0wn3r/stmbl/conf/fanuc_a05_spindle_foc_sl.txt

# Fanuc alpha 0.5 induction spindle motor, TENV
# [plate] A06B-0866-B380, delta, 4 poles, PF 0.65,
#   85-200 V (85 V at 3000 rpm, 100 Hz), S1 0.55 kW
#   3000-8000 rpm 7.0 A, S2 15 min 1.1 kW 11 A
# [plate] B-65152E: S1 0.55 kW 7 A rms (9.9 pk),
#   15 min / S3 40 % 1.1 kW 11 A rms (15.6 pk),
#   1.75 Nm S1 / 3.5 Nm S3 to base 3000 rpm,
#   max 8000 rpm, J 0.00048 kgm2, 1.32 kW max
#   during acceleration, MZ sensor 64 teeth
# Fanuc amp SPM-2.2 (200 V), model code 100;
#   B-65160E/02 app. C (conventional / HRV):
#   4100 3000/3200, 4102 5500/6524, 4103 5500/0,
#   4110 2155/1886, 4111 26/361, 4112 652/200,
#   4113 1000/1900, 4114 10/0, 4115 5/100
# [est] the manuals give no R, L, Tr or Im: the
#   electrical values below are estimates (flux
#   0.11 Vs from 85 V at 100 Hz; magnetizing
#   5.1 A pk from the SPM 9D20 firmware's 4110
#   ratio to the alpha 2; tr 40 ms from 4113
#   1000 vs 450, scaled by our measured alpha 2;
#   S1 torque then needs 5.3 A pk q current,
#   7.4 A pk in all). Run idacim on the motor
#   and replace every [est].
# sized for the v4.0 board: 5.1 A DC at rest
#   keeps the IRAM256-2067A under its derate
# variant: rotor flux FOC sensorless (S3): I/f
# start, observer above w_hand. No encoder.
# i_f, align, w_hand, hyst, obs0.bw derived
link pid
link acim_foc
link sl_acim
# drive: v4.0 board, IRAM256-2067A (30 A peak)
link ocdac
ocdac0.cur = 20 # 1.3 x max_ac_cur, measure the map first
conf0.max_ac_cur = 15 # [plate] S3 15.6 A pk
conf0.max_dc_cur = 8 # 1.32 kW at 300 V is 4.4 A
iit0.cur_boost = 1.515 # S1 9.9 A pk
iit0.max_time = 900 # S3 for 15 min
hv0.drop_k = 0.885 # dead time comp, fit per board
hv0.drop_knee = 0.85
conf0.cur_ff = 1 # r feed forward (as the alpha 2, bench 2 Nov)
conf0.cur_ind = 0 # sim: 1 slows the sensorless run up near the top
conf0.polecount = 2 # [plate]
conf0.max_vel = 838 # [plate] 8000 rpm
conf0.lq = 0 # acim_foc: l is the leakage only
conf0.psi = 0 # hv0.psi comes from acim_flux0
conf0.max_acc = 100 # raise after id_pid
conf0.max_sat = 5
acim_fw0.duty = hv0.duty
acim_fw0.p_max = 1100 # [plate] S3
# speed command through a ramp:
# ramp0.vel_ext_cmd [rad/s], enable: ramp0.en
load ramp
ramp0.rt_prio = 5.1
ramp0.vel_ext_cmd = rev0.out_d
ramp0.en = 0 # set 1 to run
ramp0.max_vel = conf0.max_vel
ramp0.max_acc = conf0.max_acc
ramp0.max_dec = conf0.max_acc
ramp0.en_delay = 0.3 # flux builds before the ramp
fault0.en = ramp0.en_out
pid0.pos_en = 0
conf0.j_sys = 0 # [est]
fault0.fb_ready = 1
fault0.mot_fb_error = 0
fault0.vel_fb = obs0.vel_m
sl_seq0.vel_cmd = ramp0.vel_cmd
pid0.acc_ext_cmd = 0
# ---- motor values (replace with idacim) ----
conf0.out_rev = 1 # [est]
conf0.r = 1.0 # [est]
conf0.l = 0.0012 # [est] leakage, Fanuc 4116 scaled on the alpha 2
acim_flux0.tr = 0.04 # [est] Fanuc 4113
acim_flux0.lmr = 0.0216 # [est] psi 0.11 / 5.1 A
acim_foc0.id_n = 5.1 # [est] Fanuc 4110
acim_flux0.i_n = 5.1 # [est]
acim_foc0.max_cur_0 = 7.5 # IRAM near DC, Fig. 5 at Tc 100 C
acim_foc0.k_boost = 2 # flux boost
acim_foc0.boost_max = 0.3
acim_foc0.k_cut = 2 # flux cut
conf0.j = 0.0008 # [est] rotor + pulley
conf0.j_sys = 0 # [est]
conf0.f = 0.06 # [est]
conf0.d = 0.00016 # [est]
conf0.o = 0
conf0.max_force = 3.5 # [plate] S3 torque
conf0.vel_bw = 80 # [est] the alpha 2 speed mode value
