0wn3r/stmbl/conf/fanuc_a2_spindle_foc_enc.txt

# Fanuc alpha 2 induction spindle motor, fan cooled
# [plate] A06B-0852-B190#3000, delta, 4 poles
#   (2 pole pairs), S1 2.2 kW 19 A rms (26.9 pk),
#   S2 15 min / S3 60 % 3.7 kW 27 A rms, 14.0 Nm,
#   base 1500 rpm, max 8000 rpm, J 0.0078 kgm2,
#   110-216 V, overload 120 % of 30 min, 1 min
# idacim input: 155 V at 78.4 Hz (2352 rpm)
# original Fanuc amp: SPM-5.5 A06B-6078-H206#H500,
#   27 A rms, 200-230 V in; parameters (FS16i,
#   B-65160E/02 app. C, units not recorded):
#   4020 max speed 8000, 4100 power base 1750,
#   4101 100, 4102 base speed 2352, 4103 flux
#   down start 2352, 4104/4105 cur P 1300,
#   4106/4107 cur I 1500, 4108 300, 4110 585,
#   4111 22, 4112 783, 4113 slip 450, 4114 high
#   speed slip comp 10, 4115 dead time comp 2,
#   motor model code 103
# [id] 13 Oct 2026 from a clean config, no hand
#   values: idacim (standstill, rotating,
#   ramps tr) + pole/direction test, id_sys
#   on the encoder, conf0.max_force =
#   acim_foc0.t_max, id_pid speed mode
#   (idacim_rot_tr df22b814)
# checked 13 Oct: 0 to +-838 rad/s both ways,
# no fault, orientation within 0.055 rad
# variant: rotor flux FOC on the encoder (S1)
link pid
link acim_foc
# encoder: 512 line sin/cos (magnetic) on fb0;
#   iabs_pos keeps the interpolation after the index
link enc_fb0
conf0.mot_fb_res = 512
enc_fb0.ires = 32
fb_switch0.mot_pos = enc_fb0.ipos
fb_switch0.mot_abs_pos = enc_fb0.iabs_pos
enc_fb0.off_k = 0.0002 # single ended sin/cos: offsets tracked, ~1 s
adc0.sin_gain = 1.5 # magnetic encoder, low amp
adc0.cos_gain = 1.5
# drive: v4.0 board, IRAM256-2067A (30 A peak)
link ocdac
ocdac0.cur = 30 # measure the map first (ocdac)
conf0.max_ac_cur = 28 # under the module's 30 A peak
conf0.max_dc_cur = 30
iit0.cur_boost = 1.1896 # S1 26.9 A pk
iit0.max_time = 1452 # S2 32 A for 30 min
hv0.drop_k = 0.885 # dead time comp, fit per board
hv0.drop_knee = 0.85
conf0.polecount = 2 # [plate]
conf0.max_vel = 838 # [plate] 8000 rpm
conf0.lq = 0 # acim_foc: l is the leakage only
conf0.psi = 0 # hv0.psi comes from acim_flux0
conf0.max_acc = 97.5 # 65% of the belt's 150
conf0.max_sat = 5
acim_fw0.duty = hv0.duty
acim_fw0.p_max = 2200 # [plate] S1, x cur_boost
# speed command through a ramp:
# ramp0.vel_ext_cmd [rad/s], enable: ramp0.en
load ramp
ramp0.rt_prio = 5.1
ramp0.vel_ext_cmd = rev0.out_d
ramp0.en = 0 # set 1 to run
ramp0.max_vel = conf0.max_vel
ramp0.max_acc = conf0.max_acc
ramp0.max_dec = conf0.max_acc
# power limited ramp: acc <= p / (j * vel)
ramp0.j = 0.0131 # conf0.j + j_sys, with tool
ramp0.p_acc = 2700 # drive power - drag at max_vel
ramp0.p_dec = 3000 # regen power when braking
ramp0.en_delay = 0.3 # flux builds before the ramp
fault0.en = ramp0.en_out
pid0.pos_en = 0
conf0.j_sys = 0
pid0.vel_ext_cmd = ramp0.vel_cmd
pid0.acc_ext_cmd = 0
# ---- identified (appended by the ID runs) ----
# idacim 13 Oct 15:52 (157ab726), pp test 15:57
conf0.out_rev = 1 # [idacim pp]
conf0.r = 0.193065 # [idacim]
conf0.l = 0.000747 # [idacim]
acim_flux0.tr = 0.101055 # [idacim]
acim_flux0.lmr = 0.01298 # [idacim]
acim_foc0.id_n = 18.738 # [idacim]
acim_foc0.max_cur_0 = 30 # IM06B50GC1 IC 35 A DC
acim_foc0.k_boost = 2 # flux boost
acim_foc0.boost_max = 0.3
acim_foc0.k_cut = 2 # flux cut, sim 29 Oct
acim_flux0.i_n = 18.738 # [idacim]
acim_flux0.lmr_sat = 0.060129 # [idacim]
acim_flux0.i_knee = 8.81171 # [idacim]
acim_flux0.tr_sat = 0.060129 # [idacim]
acim_flux0.i_dip = 8.22607 # [idacim]
acim_flux0.lmr_dip = 0.058238 # [idacim]
acim_flux0.tr_dip = 0.058238 # [idacim]
conf0.j = 0.012124 # [idacim]
# id_sys 13 Oct 16:10, encoder, 30-300 rad/s
conf0.j_sys = 0.001023 # [id_sys]
conf0.f = 0.483618 # [id_sys]
conf0.d = 0.00107 # [id_sys]
conf0.o = 0.005652 # [id_sys]
conf0.max_force = 18.8 # acim_foc0.t_max, full flux
# id_pid speed mode 13 Oct 18:39 (256a2abf)
conf0.vel_bw = 79.66 # [id_pid speed mode]
