0wn3r/stmbl/shared/f3hw.h

#include "stm32f3xx_ll_gpio.h"

//stmbl v4.0, IRAM256-2067A
#define AREF 3.338  // analog reference voltage
//PA15 drives the IRAM's FLT/EN through R129 (1k): high runs the module, low
//turns all six switches off (FLT/EN filter about 200 ns). The IRAM pulls the
//same node low on an ITRIP fault, which PB7 reads.
#define HV_EN_PIN LL_GPIO_PIN_15
#define HV_EN_PORT GPIOA
#define HV_EN_ON() LL_GPIO_SetOutputPin(HV_EN_PORT, HV_EN_PIN)
#define HV_EN_OFF() LL_GPIO_ResetOutputPin(HV_EN_PORT, HV_EN_PIN)
//fault pin cannot be used, as it is sometimes reset by the iram due to 15v ripple
#define HV_FAULT_PIN LL_GPIO_PIN_7
#define HV_FAULT_PORT GPIOB
#define HV_FAULT_POLARITY 0
#define LED_PIN LL_GPIO_PIN_8
#define LED_PORT GPIOA
#define BRK_PIN LL_GPIO_PIN_2
#define BRK_PORT GPIOB

#define VDIVUP 249000.0 * 2.0  //HV div pullup R1,R12
#define VDIVDOWN 3900.0        //HV div pulldown R2,R9
#define SHUNT 0.003            //shunt
#define SHUNT_PULLUP 15000.0
#define SHUNT_SERIE 470.0

#define PWM_U TIM8->CCR3
#define PWM_V TIM8->CCR2
#define PWM_W TIM8->CCR1

#define PWM_TIM_CLK 144000000.0  // TIM8 clock, prescaler 0, CKD div 1
// BDTR.DTG code, not a tick count: 150 = 0b10_010110 is (64 + 22) * 2 = 172
// ticks = 1.19us, about 20 % above the IRAM256-2067A's 1us minimum. DTG_TICKS
// decodes the four DTG ranges into the ticks ARR counts (valid while tim8 runs
// at CKD = DIV1).
#define PWM_DEADTIME 150
#define DTG_TICKS(v) ((v) < 0x80 ? (v) : (v) < 0xC0 ? ((64 + ((v)&0x3F)) * 2) : (v) < 0xE0 ? ((32 + ((v)&0x1F)) * 8) : ((32 + ((v)&0x1F)) * 16))
#define PWM_DEADTIME_TICKS DTG_TICKS(PWM_DEADTIME)
// PWM and F3 rt rate, set at build time (stm32f303/Makefile PWM_FREQ). The
// rt runs once per period (TIM8 RCR 1), and ls.c locks the period to the f4's
// 5 kHz packets, so only whole multiples of 5 kHz work.
#ifndef PWM_FREQ
#define PWM_FREQ 15000
#endif
#define PWM_RES ((int)(PWM_TIM_CLK / (2 * PWM_FREQ)))  // center aligned, 7200 4800 3600
#define PWM_TICKS_PER_PACKET (PWM_FREQ / 5000)          // f3 ticks per f4 packet
_Static_assert(PWM_FREQ % 5000 == 0, "PWM_FREQ must be a multiple of the 5 kHz f4 packet rate");
_Static_assert(PWM_FREQ >= 10000 && PWM_FREQ <= 20000, "PWM_FREQ out of the 10 to 20 kHz range");
_Static_assert(PWM_RES * 11 / 10 < 65536, "hv0 ARR clamp overflows TIM8");

// ADC regular sequence per ADC pair: ADC_CUR_SAMPLES current samples, then
// one slow voltage (periph.c)
#define ADC_CUR_SAMPLES 3
#define ADC_SEQ_LEN (ADC_CUR_SAMPLES + 1)

// How long the phase current sample takes, from the TIM8 trigger at the
// counter extreme: ADC_CUR_SAMPLES conversions of 61.5 + 12.5 ADC clocks at
// 72 MHz (3.1 us for three), plus about 0.5 us for the sense node to ring
// down after the low side's own switching edge (scope, 2026-09-25). io.c
// uses it to tell which phase's low side was not on for the whole window.
// In timer ticks.
#define ADC_CUR_WINDOW_TICKS ((int32_t)((ADC_CUR_SAMPLES * 74.0 / 72e6 + 0.5e-6) * PWM_TIM_CLK))

// IRAM256-2067A: the thermistor sits on the module substrate, and the
// datasheet's Fig. 9 gives Tj = 1.26 * T_therm + 27 C at full load, so 100 C
// keeps the IGBTs near their 150 C limit.
#define ABS_MAX_TEMP 100.0
#define ABS_MAX_VOLT 400.0
// IRAM256-2067A peak phase current (30 A, under 100 ms). The shunts read to
// about 37 A.
#define ABS_MAX_CURRENT 30.0

//io board
//#define USB_CONNECT_PIN LL_GPIO_PIN_15
//#define USB_CONNECT_PORT GPIOB

/*
//otter
//TODO: swap v,w cur feedback
#define PWM_INVERT
#define AREF 3.3// analog reference voltage

#define VDIVUP 56000.0//HV div pullup R1,R12
#define VDIVDOWN 2000.0//HV div pulldown R2,R9
#define SHUNT 0.003//shunt
#define SHUNT_PULLUP 5100.0
#define SHUNT_SERIE 100.0

#define LED_Pin LL_GPIO_PIN_0
#define LED_GPIO_Port GPIOA

#define PWM_U TIM8->CCR1
#define PWM_V TIM8->CCR2
#define PWM_W TIM8->CCR3
 
//ottercontrol
#define USB_DISCONNECT_PIN LL_GPIO_PIN_13
#define USB_DISCONNECT_PORT GPIOC

#define PWM_DEADTIME 50
*/
