0wn3r/stmbl/(commit log)

2026-01-15 Add possibility to keep brake during phasing
2026-01-20 Range shift Fanuc absolute turn count and adapt linrev
    Fix Fanuc battery reporting.
2026-09-11 Add brake delay timer for non-fault case
2026-09-11 Calculate temperature using Beta parameter equation
2026-10-14 f3 hv: 2 us dead time, min_on/min_off correction, dead time compensation
    - PWM dead time 2.0 us as the IPM datasheets ask (PWM_DEADTIME 196, a
    BDTR.DTG code: 288 ticks).
    - min_on and min_off are both checked against the uncorrected compares,
    so one cannot undo the other. A phase spread wider than the room they
    leave is scaled down around its center, and a per phase floor catches
    what a common mode shift cannot fix. Compare units come from the timer
    clock (144 MHz, center aligned). min_on and min_off default to 3 us.
    - Dead time compensation: while a phase current keeps its sign the bridge
    loses the dead time's share of the period times the link voltage.
    hv0.drop_k scales that i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
2026-10-14 conf templates: fix dead links in the id, pid, mpid, uf and fanuc_io templates
    id_pmsm fed fault0.sat a zero instead of the nonexistent sat_error, so the
    saturation fault no longer stays armed through identification. id_dc
    named idq0 pins that iddc does not have. id_mot fed the offset estimate to
    a renamed pid pin, so fb_torque kept its dc part and conf0.o integrated
    open loop. id_mot also runs the bare motor with pid0.j_sys 0 and gives the
    offset loop li 0.005 (25 s).
    Motor templates: fault0.min_dc_volt follows conf0.low_dc_volt (pid, mpid,
    uf); a board whose saved conf never set low_dc_volt reads 0 there. The
    vel_error links go (fault has no velocity error fault). uf and mpid link
    hv0.cur_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
2026-10-14 config words and USB: bounded config addresses, IRQ-safe host link
    - CLAMP is inclusive, so the f3 config and f4 state clamps allowed one
    index past the end. The f3 ignores config words past its own struct.
    - USB receive: usb_rx_buf is filled in the USB interrupt; the OTG IRQ is
    masked around rb_getline so commands are not merged or lost.
    - USB transmit: text and scope packets go through one IN ring writer that
    publishes the index with a single store and never laps unsent bytes.
    Scope packets go whole or not at all; text waits a little, then drops.
    - term's scope ring is 64 entries on the f4 and drops a sample when full
    instead of lapping; the f3 keeps 8.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
2026-10-14 acim_ttc: slip cap in field weakening, slip compensation, power limit
    - In slip control, holding t_boost at reduced flux needs slip ~ 1/scale^2;
    past scale = t_boost/s_boost the slip cap binds first, so t_max is
    clamped to what the cap can orient.
    - slip_comp: one linear term in the depth of field weakening for the
    Rr/Lr drift there, inert at and below base speed.
    - p_max: constant power limit, the middle region of the Fanuc slip law
    (EP0078698 eq. 17a).
    Claude-Session: https://claude.ai/code/session_01PfGZ1xgwtcbjz7i4kBXxic
2026-10-14 idacim: r, l and pole pair identification for ACIM
    Rotor blocked: r from two current dwells, with the dead time's bias on the
    chord taken out (drop_slope) or r given (r_known); l from the current's
    relaxation between two same sign levels. Rotor free: pole pairs from an
    open loop rotating field. link id_acim.
    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
2026-10-14 Makefile: add DOCS switch to skip doc generation
    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
2026-10-14 hw v5.0: shunt value, the fitted IKCM30F60GD named, interactive BOM regenerated
    - The shunts are 3 mOhm.
    - The KiCad files named the fullpack IKCM30F60GA; the boards carry the DCB
    IKCM30F60GD (same body and lead pattern, only the heatsink notch
    differs): symbol, footprint, 3D model, datasheet, ERC/DRC parity.
    - bom/ibom.html regenerated (KiCad 8.0.9, InteractiveHtmlBom 2.12.0):
    U12 and the 3 mOhm shunts now read right.
    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
2026-10-14 hv: power and dc current estimate, conf0.lq, commutation advance, out_rev vel
    - hv0.power = 3/2 (ud id + uq iq) from the commanded voltages, lightly
    filtered, and hv0.dc_cur = power / dc_volt for fault0's derate; both
    negative when braking, both a little low as they leave out inverter
    losses. The board does not measure dc current.
    - conf0.lq goes to the f3 as a config word and on to curpid0.lq, so each
    axis gets its own gain and decoupling. 0 keeps l for both axes.
    - hv0.adv [s] sends pos + vel * adv to the f3 (default 0). The pid
    template runs hv0 after pmsm, so it sends this tick's angle.
    - With out_rev, vel is negated along with pos and q, so the f3's position
    extrapolation an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
2026-10-14 f3: bridge off when the rt stops, W comparator on BRK2, IWDG, V/W overcurrent
    - iabs takes ABS() of all three phases, so negative V and W currents
    reach the software overcurrent checks.
    - TIM8 keeps the last compares when the rt stops; the tick clears MOE and
    the driver enable when it finds the rt stopped.
    - COMP1, phase W's overcurrent comparator, trips TIM8 through BRK2.
    - Independent watchdog at 5 ms from the LSI (HAL_WATCHDOG, f3 only). Only
    the rt kicks, at the end of a completed run, and only while the nrt has
    come round within the last second, so a stopped rt, a hang with irqs
    off or an nrt stuck for 1 s all end in a reset; after the reset HV_EN's
    pull-up holds the gates o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
2026-10-14 f3 rt: FPU sqrt, folded ADC scaling, shared sin/cos, rt path in CCM RAM
    io folds the scaling constants into one multiply per sample; idq0 reuses
    dq0's sin/cos; curpid takes the square root only above max_cur. The rt
    funcs, TIM8_UP_IRQHandler and hal_run_rt run from .ccmram, copied there in
    main(): flash has two wait states and no cache on the F303.
    On X: f3 rt peak 64.0 -> 40.8 us of 66.7.
    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
2026-10-14 encf, linrev, fanuc: bounded frame decode, turns at the pos wrap, abs_rev every tick, 16 sectors
    encf:
    - The edge to bitstream expansion is bounded (a noisy frame used to run
    into print_buf); the frame is built a word at a time, crc5 uses a nibble
    table and the angles wrap without fmodf: 32.5 -> 14.0 us on X.
    - Bit time from the 84 MHz TIM4 clock; the CRC-clean window on X is
    986k-1060k around the default 1.024 Mbit/s.
    - turns steps exactly where pos wraps for any pos_offset and equals the
    encoder's count at pos = pos_offset; within a quarter turn of the
    encoder's own step the value is held. pos_offset applies in every state.
    - At the first index after an un-indexed start the encod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
2026-10-14 f3 emf0: per pole back emf map on a bridge off coast
    emf0 runs on the f3 with the bridge off and sums every pwm period's
    unfiltered phase voltage sample against ls0.pos: psi, the 5th and 7th
    harmonic back emf, and psi per magnet pole (16 bins, up to 8 pole pairs),
    with the phase channels' dc offset taken out. Config words
    emf_run/emf_sel/emf_pp and state word emf_val carry it to the f4.
    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
2026-10-14 f3 hv: dead time compensation curve hv0.drop_knee
    drop_knee > 0 scales the compensation by k(i) = 1 - 1/(1 + |i|/knee)^2 of
    each commanded phase current instead of the latched sign. The latch needs
    drop_band of current to flip, so an unloaded axis sat with a fixed voltage
    vector; the curve cannot stick and falls away like the real loss. On Y the
    once per turn ripple went 1.0 -> 0.018 A. drop_knee is a config word; 0
    keeps the latch.
2026-10-14 id_pmsm, id_tune: r, l, psi and offset tests; adv and drop_k
    id_pmsm:
    - r: d dwells at four angles and seven currents, fitted as
    ud = r id + V0 dproj(id, th, knee), the d projection of hv.c's dead
    time curve; prints conf0.r, hv0.drop_k and hv0.drop_knee. With r_known
    only V0 and the knee are fitted. Each new angle starts from 0 A for
    0.2 s, and after the first two dwells the current loop takes r from
    their slope (or r_known), so the steps do not overshoot.
    - l: a sine on d, then q, over the r test's bias: conf0.l and lq. It
    injects at the current loop's crossover, conf0.cur_bw / 2 pi
    (idpmsm0.loop_bw; 480 Hz at 3000), rounded to whole cycles per window;
    l_freq overrides it. Y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
2026-10-14 f3: software overcurrent trip on max_cur, filtered comparators per RM0316
    - io0 trips HV_OVERCURRENT_PEAK in the same tick when iabs exceeds
    oc_k * max_cur (1.3, at least oc_min 5 A, at most ABS_MAX_CURRENT).
    - COMP2 (U) and COMP1 (W) go to TIM8 BRK2, which has a digital filter
    (BRK_ACTH has none, RM0316 table 27); all three rise ~3-4 counts/A.
    - DAC1 output buffer off: buffered it only reaches down to 0.2 V and the
    thresholds sit at ~0.1-0.3 V.
    - TIM8 OSSR = OSSI = 1 and BK2E in its own BDTR write after BK2P
    (RM0316 20.3.16); break flags from the setup cleared.
    - io0.cu/cv/cw read COMP2/COMP4/COMP1 (PA7 U, PB0 V, PA1 W).
    - COMP CSRs locked after setup, no hysteresis (it held the out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
2026-10-14 fault, ipm: short brake, regenerative stop, IPM junction temperature model
    - fault0.sbrake_en: when the drive stops from a powered state for a
    reason that leaves the bridge healthy, fault0 asks for sbrake_time (1 s)
    of braking through a packet flag. The f3 turns all three low sides on
    and chops the current at io0.sbrake_cur (default max_cur, at most
    0.8 x oc_lim). It refuses after any trip since the last enable and stops
    on a trip while braking. With sbrake_arm the f3 also brakes on its own
    when the f4 goes silent while the motor was driven.
    - fault0.rstop_en: on a stop that leaves the feedback, the f3 link and
    the link voltage good, pid0.stop commands zero speed for up to
    rs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
2026-10-14 f3 adc: dual simultaneous mode, PGA sampled 61.5 cycles, rebuild the unsampled phase
    - ADC1/2 and ADC3/4 run regular simultaneous (DUAL 00110, MDMA 10); DMA,
    DUAL/MDMA and DMACFG are all set before the ADCs are enabled
    (RM0316 15.5.4, 15.6.3). Slaves are enabled first.
    - The PGA outputs are sampled for 61.5 cycles (DS9118 table 77 asks for
    at least 400 ns), three current ranks plus the voltage. ADC4 follows
    rank for rank: hv_temp, hv_temp, mot_temp, udc; hv_temp is taken from
    rank 2, after a same-channel sample.
    - A phase near full duty has its low side on for too short a time to be
    sampled; io.c checks each phase's low-side pulse against the sample
    window and the dead time and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
2026-10-14 f3 pwm: shift by the deficit, voltage on its own angle, vector voltage limit
    - The min_on/min_off shift moves the phases by what the offending phase
    lacks. min_on and min_off are floored at the dead time plus 0.5 us.
    hv0.duty_max exports the usable duty, wired to ls0.duty_max, which
    scales pwm_volt (unwired: 0.95).
    - The voltage is applied over the next period, 1.5 periods after the
    current sample on average: ls0.pos_v = pos + vel * v_lead * period
    (v_lead 1.5). idq0 runs its own sincos at pos_v and exports it for hv0's
    dead time reference. hv0.adv is the encoder-to-sample latency only.
    - The duty is divided by io0.udc_duty, a 0.5 IIR of the link voltage;
    io0.udc stays slow for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
2026-10-14 f3 shutdown: CSS, ARR preload, debug freeze, break interrupt, conf_ok gate
    - Clock security system on (RM0316 20.3.16); the CSS NMI clears CSSC,
    turns the bridge off and stops the hal.
    - TIM8 ARR preloaded, so a phase lock trim cannot skip an overflow.
    - DBG_TIM8_STOP: a breakpoint turns the outputs off.
    - Fault handlers turn the bridge off, record the fault and spin until the
    watchdog; SYSCFG LOCKUP_LOCK routes a core lockup to TIM8's break.
    - TIM8 LOCK level 1 after the break setup.
    - Software trips clear MOE in the same tick, as the comparators do in
    hardware. TIM8_BRK_IRQHandler (priority 0, above the rt) raises HV_EN
    within about a microsecond of a comparator break, so the IPM t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
2026-10-14 f4: DMA re-arm per RM0090, ADC overrun stop, enc_fb, io4, EnDat fixes
    - dma_stream_stop() (inc/dma_util.h) waits for EN = 0 and clears all five
    stream flags before a re-arm (RM0090 10.3.17), in hv, encf, encs,
    yaskawa, sserial, siserial, usart, smartabs, encm, dmm and
    smart_torque. The HV RX stream gets NDTR set before each re-arm.
    - An ADC overrun stops the hal with MISC_ERROR (RM0090 13.8.1); the rt
    would otherwise stop silently.
    - enc_fb: IC1F = IC2F = 0011 (~95 ns) set in CCMR1 after the encoder
    config. DMA2_Stream0_IRQHandler latches TIMx->CNT and the A/B port IDR
    first thing, about 4 us after the last sample; enc_fb uses those, so
    the quadrant check matches the ADC group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
2026-10-14 conf templates: adc0 only where read, reslimit0 after rev0, acim hv0.vel
    - adc0 is scheduled only in res_fb0, enc_fb0, uvw_fb0, uvw_fb1 and wobl;
    it took 45.7 us of the 200 us rt on a Fanuc encoder axis.
    - pid template: reslimit0 runs after rev0, so pos_ext_cmd is from the
    same tick as the velocity and acceleration feedforward. Y pos_error rms
    at 100-300 rad/s: 1.9-5.7 -> 0.7-0.9 mrad.
    - acim template: hv0.vel from acim_ttc0.vel_e, the synchronous speed with
    slip, for the f3's extrapolation and decoupling.
    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
2026-10-14 f3 io, ipm_im06b50gc1: held IPM temperature decays, Rth from the SOA chart
    - While held, hv_temp decays toward the coolest live reading since power
    up with a 90 s time constant, so a held overtemperature can clear
    without a power cycle; the first live reading after a hold is taken as
    it is. Short braking keeps HV_EN low, so hv_temp is read live 5 ms
    after braking starts.
    - r2temp shows 0 only below 500 ohm and computes ln in float (ln_f, under
    0.0001 K from the double result): 880 B less flash.
    - ipm_im06b50gc1: Rth x2.84, fitted to the datasheet's SOA chart (Fig. 12)
    extended to a 30 C water cooled case.
    Clau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
2026-10-14 ocdac, id_dac: hv0.dac from a trip current; ABS_MAX_CURRENT 35 A
    - ocdac sets hv0.dac from a wanted trip current through a fitted linear
    map, dac = dac0 + k * I. The measured maps are documented in ocdac.c
    (spindle IM06B50GC1 on filter 0xC).
    - id_dac: one shot hv0.dac search for a wanted trip current, free or
    loaded axis.
    - ABS_MAX_CURRENT 35 A, the measurement range of the 3 mOhm shunts. The
    module limit comes from conf0.max_ac_cur through io0's oc_k * max_cur
    trip; its template default is 10 A.
    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
2026-10-14 angle, acim_flux, acim_foc, acim_fw: shared commutation angle and rotor flux FOC
    angle owns hv0.pos and hv0.vel for every motor type. src 0 passes the
    feedback through, and pid.txt and pmsm.txt route it, so PMSM axes send the
    same values as before. src 1 integrates rotor speed plus slip (induction
    motor on an encoder), src 2 takes an observer, src 3 an open loop
    frequency; vel is always synchronous electrical speed.
    acim_flux models i_mr with tr, gives slip = iq/(tr*i_mr) and psi =
    lmr*i_mr for hv0.psi, which turns curpid's decoupling into the induction
    motor's stator flux with conf0.l = sigma*Ls. acim_foc ramps id from 0 at
    every enable, holds torque until the flux is up, and limits q so d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
2026-10-14 vf: V/f on the shared angle with damping, stall prevention, encoder path
    vf is an open loop V/f drive on angle0 src 3, so hv0.vel is the
    synchronous speed and the f3 extrapolates the angle between packets. uf
    stays for existing configs.
    - Its own ramp (acc, dec); holds deceleration while the dc link is above
    dc_hold; a boost that fades out at boost_vel; the derate lowers the
    stall current.
    - Stall prevention on the active current (low passed at damp_hz):
    full acc up to i_stall, a hold at 1.1 * i_stall, backing off at up to
    stall_dec by 1.3 * i_stall.
    - Slip compensation from the low passed signed active current, right in
    reverse and when braking.
    - k_damp moves the field frequency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
2026-10-14 obs, sl_seq: shared flux observer and sensorless start for PMSM and ACIM
    - obs: PI phase locked loop on the back emf from voltage and current, in
    its own frame, so it can run as a shadow next to the encoder
    (obs_check template). It uses the sine of the error with the sign of
    rotation. r_w adds a d loss that grows with speed (induction motor
    iron loss), default 0. u_delay defaults to 0: the f3's voltage angle
    already leads by v_lead. The ACIM slip reaches vel_m through a copy of
    the tracking loop, so an iq step does not dip vel_m (that fed back into
    pid and rang at the observer bw on the spindle).
    - sl_seq aligns with i_f on d, runs I/f up to w_hand, hands angle0 to obs
    (src 2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
2026-10-14 acim_flux, angle, acim_fw, acim_foc: tr/lmr adaptation and saturation, FW feedforward, flux boost
    acim_flux (all new pins off by default):
    - tr_ki: tr adaptation from the reactive power residual
    (Q - Q_m) sign(w), within 0.5..2 x tr, gated by tr_iq_min, tr_vel_min,
    tr_flux_min and tr_acc_max.
    - tr_ks: tr from sl_seq0.slip_err in sensorless mode (Fanuc US8294411B2).
    - lmr_ki: lmr trim from the steady q voltage residual.
    - tr and lmr grow below rated flux (tr_sat, lmr_sat), stay at their
    plateau below i_knee, and fall below i_dip by lmr_dip.
    angle src 1 builds the field angle from the encoder angle plus integrated
    slip.
    acim_fw: flux feedforward scale_ff = duty_setpoint * pwm_volt /
    (|ve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
2026-10-14 idacim: leakage, tr and Lmr fit, V/f set, rotating flux sweep, inertia
    - l: injection on d at a pair either side of the current loop's
    crossover, 0.75 and 1.5 x conf0.cur_bw / 2 pi (idacim0.loop_bw;
    360/720 Hz at 3000), rounded to whole cycles per window;
    l^2 = (|Zb|^2 - |Za|^2) / (wb^2 - wa^2), stepping up an octave while
    w l is small. The cage's leakage falls with frequency (spindle: 0.93 mH
    at 120/240 Hz, 0.75 at 360/720), so l is measured in the loop's band.
    - Rotor test: d steps between test_cur and test_cur/2 at standstill; each
    edge fits lmr, tr and its own offset; lmr = median of the falling edges,
    tr = mean of the rising and falling medians. Spindle at 16 A: lmr
    13.0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
2026-10-14 iit: double state, so a minutes-long time constant still integrates
    At a motor-length time constant a float e is so large that one period's
    increment rounds away, and the estimate stalls short of its final value.
    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
2026-10-14 F4 and F3 on CMSIS 5 and the Cube LL drivers; CubeIDE project; V3/F1 removed
    - CMSIS 5 core headers, STM32F3xx/F4xx device, system and startup files
    from STM32CubeF3/F4. newlib-nano on the f4 and the f3 (float printf
    and scanf kept), nosys.specs for the f4.
    - F4 app and bootloader on the STM32CubeF4 LL drivers; USB CDC on the
    Cube USB Device Library v2.11.4 over HAL PCD (SYSCFG clock enabled, D+
    held detached for 20 ms before connecting). The StdPeriph and old ST
    USB libraries are removed. Clock tree in f4_clock.c, shared by app and
    bootloader. Config save and hardboot program the flash on registers.
    enc_cmd and enc_fb use LL_TIM_ENCODER_Init. The resolver ADC trigger
    edge is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
2026-10-14 rt speed: GCC builtins, fewer divisions, code in SRAM, atan2_fast; F3 ls ramp; PWM frequency option
    - GCC builtins and -fno-math-errno, so sqrtf/fabsf are single
    instructions; the f3 adds -fno-tree-loop-distribute-patterns and
    -freciprocal-math, -O2. The bootloaders keep -fno-builtin.
    - mod() compares and subtracts within +-3 pi. emf0's rt, mod() and term's
    rt run from SRAM (.ramfunc). SysTick at priority 14, below the rt.
    hv computes 1/udc and 1/pwm_res once a tick; curpid caches 1/ld, 1/lq.
    - F4: atan2_fast (CMSIS-DSP arm_atan2_f32 polynomial, Apache-2.0) in
    enc_fb and res, sincos_fast in ipm; the unused CMSIS-DSP headers are
    removed.
    - f3 ls: the 5 kHz d/q commands ramp over t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
2026-10-14 ringbuf, USB and the hv link: IRQ-safe ring, port-open gate, hv_update and link fixes
    - ringbuf: separate read and write positions, one slot free, safe
    between an IRQ and nrt; rb_getline drops a fragment that can never
    become a line and resyncs at the next '\n'.
    - f4 usb: every SETUP flushes EP0 IN; nothing is sent until the host
    opens the port (DTR or the first received byte), then 100 ms later.
    - hv_update: f3_boot skips pages that are already blank and the f4
    allows 12 s for the erase; CRC_CHECK is sent once and the f4 listens
    20 ms for the answer, repeating until 400 ms. hv_verify reads the f3
    app area back through the bootloader and compares it with the
    embedded image.
    - f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
2026-10-14 CubeMX reference .ioc files; conf template conf0.cur_bw 3000
    cubemx/ holds .ioc files for the F405 and F303 with the pinout, clock
    tree, peripheral modes, DMA and interrupt assignments the firmware sets
    up, for viewing and checking; the init code stays hand written. The F303
    PLL runs from HSE x 9 (72 MHz) as in periph.c. The 2017 pinout sketches
    in hw/kicad/v5.0/doc are removed.
    conf0.cur_bw 3000: on X the d-step rise is 0.8 ms at 3-10 A with at most
    1% overshoot.
    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
2026-10-14 conf templates: pid, mpid, uf and vf link ipm; ipm f_sw from hv0.pwm_freq
    Each motor template links ipm at its end, so the junction model and its
    derate run on every axis; ipm_im06b50gc1 still goes after the motor
    template. ipm.txt links ipm0.f_sw = hv0.pwm_freq.
    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
2026-10-14 id: fix iddac, idpmsm, idtune and idm review items
    - iddac: a failure before the search starts restores dac_lo; the header
    and template give the real hv0.max_cur check.
    - idpmsm: clamp the psi speed loop integrator to test_cur; warn when the
    dead time knee lands on the grid edge and when dc_volt is unwired;
    check absolute feedback after the pp test; reset com_fb_offset/ok in
    state 0.
    - idtune: test convergence before the adv limits.
    - idm: pos_fb pin, the profile starts from the rotor position; state 13
    honours sys in the inertia clamp.
    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
2026-10-14 sserial, linrev, hv_update, io4, siserial, smart_torque: link and review fixes, aged pos_fb
    - sserial: a bad crc packet is counted and the last good command kept
    for up to two in a row; a third sets error and zeroes the outputs
    until a good packet. The reply crc is written before the tx DMA starts.
    - linrev: rev counts fb_in's wraps and is taken from abs_rev only when
    the source becomes absolute or its count jumps by more than a turn;
    abs_neg negates abs_rev/abs_pos for the take (sserial templates link
    conf0.mot_fb_rev). rev_clear zeroes rev in absolute mode too.
    - hv_update: SEND_APP stops after the last word; FLASH_FAILED alternates
    a bootloader NOP with an app packet and retur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
2026-10-14 ids, idm, pid: id_pid search on conf0 limits, idm plateau fit, id_lpf; pid speed loop P term unclamped
    ids:
    - start values from conf0.pos_bw, vel_bw and vel_d (10 / 100 / 10 when
    0); a start that saturates is cut by kd and retried, up to CUT_MAX.
    - warm-up cycles after enable until pid stops saturating, up to
    WARM_MAX (25); the profile starts at pos_fb (fb_switch0.pos_fb).
    - each score averages rep cycles (default 2); cycles with pid0.sat or
    the torque at 0.99 x conf0.max_force are skipped (ids0.skipped).
    - a step fails when fb_torque above 50 Hz exceeds fb_max x max_torque
    rms; the torque peak is reported, not scored.
    - a raise is kept only while it cuts the cost by kg (0.05).
    - lim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
2026-10-14 sl_seq, acim_fw: sensorless defaults from the motor values
    sl_seq: align_time 0 = 3 * tr, w_hand 0 = the speed where the emf is
    5 * obs0.e_min, hyst 0 = w_hand / 3; sl_seq0.align and hand show what is
    used. acim_fw: ls 0 = l + lmr_act, ki 0 = 2.5 / tr_act. The templates
    link i_f = id_n, tr, lmr, psi, e_min, l; values set in a config win.
    acim_fw p_max is the S1 power times p_boost (iit0.cur_boost in the
    template): field weakening gets the same overload headroom as the
    current, iit0 limits how long.
    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
2026-10-14 sl_seq: obs_bw output (5 x w_hand x polecount), sl_acim links obs0.bw to it
    The template said to set obs0.bw by hand to about 5 * w_hand * polecount
    (spindle: 300); it is derived now, a config value still wins.
2026-10-14 f3: power stage and link fixes from the component review, trip on the rated current
    io0:
    - a fault pin trip takes MOE off in the same tick, like the other
    software trips
    - the enable edge clears a break left from idle and re-arms the break
    irq, so an enable right after one is not reported as
    HV_OVERCURRENT_HW
    - the offset fault stays until reset
    - recon reads the compares through PWM_U/V/W
    - lo_u/v/w start long, so the first tick does not rebuild a phase
    ls0:
    - pwm_volt from io0.udc_duty, the link hv0 divides by
    - hv_temp_ok appended to the f3 state, hv0.hv_temp_ok on the f4 (an
    older f3 leaves it 0)
    - sbrake_time default in nrt_init, d/q targets and steps reset in
    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
2026-10-14 pmsm_ttc: MTPA id/iq split behind pmsm_ttc0.mtpa (default off)
    With ld != lq the reluctance torque 1.5 p (ld - lq) id iq adds to the
    magnet's. mtpa 1 puts the torque command on the least current curve:
    id = (psi - sqrt(psi^2 + 4 dl^2 iq^2)) / (2 dl), dl = lq - ld, with iq from
    T = 1.5 p iq (psi - dl id), two fixed point passes from last tick's id.
    On Y (psi 0.07057, dl 1.107 mH, pp 4) 16.3 A gives id -3.7 A and 3.0 %
    more torque than id 0, within 0.1 % of the exact optimum.
    pmsm_ttc0.id = id_in + the MTPA id; pmsm and mpmsm link id_in to
    fb_switch0.id and hv0.d_cmd to pmsm_ttc0.id, sl_pmsm its d_in, so with
    mtpa 0 (or lq 0) d_cmd is fb_switch0.id.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
2026-10-14 motion and open-issue fixes: idx_home, ramp, home, fb_switch, vel_int, velbuf, veltopos, iit, pe, fault
    - sserial template links idx_home0.mot_state to fb_switch0.mot_state_fb
    (the input pin read 0, so index homing never completed); each request
    clears waitabs and lastq, so a later request waits for its own zero
    crossing.
    - ramp at_speed and the home exit work in both directions.
    - fb_switch: mot_joint_ratio defaults to 1 and applies in the absolute
    joint path; the plot shows pos_fb. The templates drop the nonexistent
    fb_switch0.joint_polecount lines.
    - vel_int detects edges per instance, velbuf's fallback spans 19
    periods, veltopos applies max_vel after the clamp; the velbuf tem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
2026-10-14 melody: play tunes, a ready chime and identify on the d-axis current
    New F4 comp melody and template melody.txt (link after pmsm): melody0 sits
    between fb_switch0.id and hv0.d_cmd and adds an audio-rate square or sine of
    peak amp amps while fault0.en_pid is set. Commands tune <notes>,
    tune +<notes> (adds, since a terminal line holds 63 characters), tune ode,
    tune, tunex and identify; a C4 E G C5 chime on the first enable after
    power-up. A line with a bad note leaves the loaded tune alone.
    Default amp 6 A: about 3-4 A at the motor is audible. With conf0.cur_bw
    3000 the loop passes about 2/3 (C5) to 9/10 (C4) of the command.
    Templates: melody0.in = pmsm_ttc0.id, so link melody after link pmsm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
2026-10-14 comments: drop stale history notes, fix comments the code outgrew
    Comments only, no code change (checked per file with the comments
    stripped). Notes about earlier versions, commit hashes and dates are
    reworded to state the current design and its reason, or removed.
    Comments that no longer matched the code are corrected: ids no longer
    mentions pid's max_acc clamp, emf0's packet rate follows
    PWM_TICKS_PER_PACKET, the f3 ADC setup is in periph.c, periph.c's -O2,
    and the vf duty and idacim j_tv pin comments are back on their pins.
    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
2026-10-14 enc_cmd: step/dir (mode 1) and dir/step (mode 2) on the CMD port
    TIM2 counts step edges in external clock mode 1; each dir edge captures
    the step count in hardware (CC2/CC1 on both edges), so the reversal step
    is exact whatever the interrupt latency. A TIM2 interrupt takes the
    captures and the rt takes any it finds pending. A lost dir edge (CCxOF)
    latches the new error pin, as does a mode the remap cannot do (up/down,
    or step modes on FB0/FB1). The template links fault0.cmd_error to it.
    Quadrature (mode 0) is unchanged.
    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
2026-10-14 conf: Fanuc alpha 3/3000 axis and alpha 2 spindle examples
    - fanuc_a3-3000: Kira Y axis on a 10 mm/rev ball screw, LinuxCNC over
    sserial, absolute encf. Nameplate, datasheet B-65142E/02 and stock amp
    values as comments; each line tagged [plate], [id] or [calc]; motor and
    loop values identified on the axis on 9 Oct 2026.
    - fanuc_a2_spindle_vf, _vf_enc, _foc_enc, _foc_sl: Fanuc alpha 2
    induction spindle on a water cooled IM06B50GC1 bridge, motor values
    from the idacim standstill and rotating tests of 9 Oct 2026. Each header
    says what was checked: V/f encoder, FOC encoder and FOC sensorless to
    8000 rpm; open loop V/f 20 to 838 rad/s with vf0.vel_src 1, k_vel 1.0.
    FOC friction f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
2026-10-14 acim_flux: tr_dip, tr's own low flux coefficient
    The low flux dip applied lmr_dip to tr as well, so on the spindle tr_act
    fell to 0.074 at i_mr 5 A where tr is about 0.11 (6 Oct sweep, 9 Oct
    bench: tr 0.1114 cleared the sensorless ripple at 838 rad/s, iq sd 8.6 ->
    1.7 A). tr now takes tr_dip, default 0 (no dip on tr); negative raises tr
    at low flux. Spindle sensorless example -0.45 (0.099 at 8 A, 0.112 at 5 A),
    the encoder example keeps its old behaviour with tr_dip = lmr_dip.
    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
2026-10-14 tests/sim: host simulation harness for the F4 and F3 firmware
    The F4 hal and the F3 current loop compile on the host against a PMSM
    two-mass plant and an inverse-gamma induction motor plant (acim_flux's
    saturation shape, enc_fb0 encoder output, optional hv.c dead time curve;
    the flux curve is solved from the last step). Scenarios: Y moves and
    rings, spindle FOC on the encoder, in field weakening and sensorless,
    V/f open loop and encoder, idpmsm, id_mot and idacim against plants with
    known values (regression), FRF creep and two-mass fit (scen_frf, not in
    make test: 55-90 s each).
    Claude-Session: https://claude.ai/code/sess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
2026-10-14 term: scope protocol v1, 128 byte lines, CPU-only buffers in the F4 CCM
    - term0.fmt 1 sends float samples (0xfd + seq + 8 floats); fmt 0 keeps the
    8-bit packet, clamped to 253. Numbers are base-250 digits + 1, so the
    markers 0xfb..0xff stay unique. seq counts every live sample; a 0xfc
    header (period, channels, kind) on connect and on format changes;
    capture of 1024 x 8 floats on the F4 with level/edge trigger and
    pre-trigger, uploaded as 0xfb frames (term0.cap_*); fmt 0 or cap_arm 0
    aborts a capture, a finished one waits for the next host; text leaves
    1 KB of the tx ring to the scope; "#n command" is answered "#n done".
    Spec: docs getting_started/servoterm_protocol.md, host s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
2026-10-14 fluxopt: light-load flux reduction for acim_foc
    scale = sqrt(|T| / (1.5 pp lmr)) / id_n (copper-loss optimum id = iq),
    floored at min, capped by acim_fw0.scale, rises at once and falls at
    fall_hz. The acim_foc template loads it between acim_fw0.scale and
    acim_foc0.scale with min 1 (off); fluxopt0.min 0.5 in a config turns it
    on. Spindle bench 12 Oct: idle copper loss 111 -> 28 W, start torque 9.8
    vs 13.9 Nm until the flux is back.
    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
2026-10-14 dob: disturbance (load torque) observer on the torque command
    d = j dw/dt - u from a raw position-difference velocity, low passed at
    bw Hz, k * d subtracted from the torque. k 0 by default (estimate only); off while j <= 0 (the default), where it
    would cancel the drive's own torque command.
    Sim on Y: load-step error 2.5-3x lower at bw 50-100 Hz, 200 Hz
    oscillates; bench on Y: with the friction feedforward off, bw 50 halves
    the error. Not wired in any config.
    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
2026-10-14 biquad, frf: torque command notch, stepped-sine FRF with a two-mass fit
    biquad: second-order filter on a command signal (type 0 pass-through, 1
    notch with f0/q/depth, 2 low pass), RBJ bilinear coefficients, restarts
    from steady state on a parameter change.
    frf (first instance only, the fit arrays are static; losing en stops the
    sweep): stepped sine torque injection with the loop running; it creeps the
    axis back and forth inside min_pos..max_pos about the start (pid0 ext
    commands), measures while cruising and returns to the start. Correlates
    the torque command, the controller torque and a raw position-difference
    velocity over whole cycles; prints G, gj = |G| w and the open loop L per
    point, t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
2026-10-14 vel, vel_int, rev, sserial: velocity feedforward timing, acceleration feedforward from the host
    - vel.vel_p adds the tracking loop's proportional term to vel (the
    integrator alone trails the speed by 2 d / w in steady acceleration);
    vel_int.vel_ip extrapolates vel_out by the change of vel_in since the
    previous frame. Both default 0; fanuc_a3-3000 sets them 1. On Y the
    drive ran ~38 um ahead of LinuxCNC through every acceleration; sim 50 mm
    at 750 mm/s2: steady error -32.4 -> 5.0 um.
    - vel_int0.acc_out: the per-frame change of vel_in, held until the next
    frame, 0 while the watchdog holds; acc_k scales it (0 = off), max_acc
    clamps it. rev gets in_dd/out_dd; the sserial templates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
2026-10-14 flux_obs: hybrid rotor flux observer for the induction motor, slip trim
    Voltage model rotor flux in the stationary frame, blended (Jansen/Lorenz
    PI) onto the current model below wc (20 rad/s el), for the spindle on its
    encoder. It measures the orientation error of the current model (pos_err)
    without tr and optionally trims the slip: slip = slip_in * k + kp_s *
    pos_err, k = tr_model / tr_true learnt by ki_s, gated by speed, flux and
    slip; the kp term is bounded to 0.5 |slip_in| + slip_min and the output
    to acim_flux0.slip_max. Shadow by default (kp_s 0, ki_s 0); angle0.slip =
    flux_obs0.slip turns the trim on. Voltages are taken half an rt period
    behind the current's frame (u_adv 0 = -period /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
2026-10-14 idacim: tr from the rotating ramps, flux sweep at constant emf, rotating tr check
    - Two pairs of up/down ramps (id_n and 0.65 id_n): tr from the air gap
    torque difference over the slip difference, slip from the encoder
    position (idacim0.pos_fb = fb_switch0.vel_fb); the second pair separates
    the field to position delay; prints acim_flux0.tr from the ramps. A slow
    trim holds id and iq on target so both ramps see the same current. The
    flux sweep runs after the ramps with their tr, each level at the ramps'
    top emf (up to rot_vmax of plate speed); tr per sweep point from the
    flux angle in the voltages over the encoder slip is reported; the knee
    fit prints acim_flux0.tr_dip (= lmr_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
2026-10-14 ids, idm: vel_bw searches down when the first raise fails, speed mode search for pos_en 0; idm two-bin fit
    - When vel_bw's first raise gains nothing, vel_bw is cut by step while
    the cost stays within kg of the start value's, down to 4 pos_bw
    (spindle, magnetic sin/cos encoder: the default 250 had 2.5-3x the
    current noise of a hand set 40).
    - Speed mode (state 1.5, template ids0.pos_en = pid0.pos_en): a spindle
    has no position to track, so id_pid runs to +-max_vel, measures the
    speed noise over 4 cycles of 2 s, puts a load step of dist x max_torque
    against the motion (pid0.torque_ext_cmd = ids0.torque_dist) and takes
    the dip; the dip decides, the speed noise only guards (3 kg).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
2026-10-14 vf: no voltage and a stopped field at a 0 command once the ramp is at 0
    The boost drove a dc current into the limit at standstill (spindle 21 A)
    and the encoder path's speed PI on 0 hunted with the field near 0 Hz
    (+-17 rad/s, 29 A peaks). With cmd and the ramp at 0 the field stops and
    no voltage is applied; a new command restarts the PI from the open loop
    slip. A command below 0.5 rad/s counts as 0 and the damping resets there.
    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
2026-10-14 conf: spindle examples from a clean config and the ID tools (13 Oct bench)
    conf/fanuc_a2_spindle_{foc_enc,foc_sl,vf,vf_enc}.txt carry only hardware,
    plate and safety values plus tool output: idacim (standstill, rotating,
    ramps tr, knee/dip incl. tr_dip) and the pole/direction test, id_sys on
    the encoder, conf0.max_force = acim_foc0.t_max, id_pid speed mode. Gone:
    the hand tr_dip, lmr_dip, r_w, obs0.r/bw, sl_seq start values, acim_fw
    duty/ki, vel_bw 40. u_boost 14.6 from idacim; ramp0.en_delay 0.3 on the
    FOC examples (acim_foc gives no torque for ~280 ms after enable while the
    flux builds). conf/bench/spindle_2026-10-13 holds the bench versions.
    Bench: all four paths 0 to +-838 rad/s both way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
2026-10-14 idtune, idpmsm: the speed loop works at a negative test_vel
    The integrator clamp (v_t / 100), the stall check and the settle band
    used v_t's sign: at test_vel < 0 the clamp inverted and the rotor ran
    forward (A axis, 78 motor revs the wrong way). |v_t| everywhere, the same
    in idpmsm's psi spin and coast thresholds. Sim id_tune_neg: adv 331.6 us
    reverse as forward.
2026-10-14 f3: free CCM: rt objects built with -Os, io's rare paths in flash
    CCM (8 KB) held 8176 B of rt code, 16 B free, which blocked every F3 loop
    addition (review item A5). Two changes:
    - io rt_func: the offset calibration (first 201 ticks), the enable edge
    and the short brake move into noinline functions that stay in flash.
    The per-tick sampling, reconstruction and every trip stay in CCM.
    8176 -> 7584 B.
    - ls, io, curpid, idq and hv are built with -Os instead of -O2.
    7584 -> 7232 B.
    CCM now 7232 B, 960 B free. Instruction counts of the five rt functions
    in a unicorn run of one tick are within 1 % of the -O2 build; the rt time
    needs a bench reading (the HAL rt time on the F3) before anythi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
2026-10-27 sserial: position on a filtered request clock (req_k)
    The drive answers each process data request when it handles it, and
    that time varies (host servo jitter, 50 us frt steps): 950-1050 us at a
    1 ms servo period on the spindle bench. LinuxCNC takes each reply as the
    position at its own 1 ms tick, so spindle.0.revs stepped +-16 % per
    period at 300 rpm and Z, synced to it in G33.1, buzzed.
    With req_k > 0 the reply times go through a critically damped second
    order filter and pos_fb is extrapolated to that clock instead of the
    actual reply time. Mean offset 0, so pos_advance is unchanged. Host
    test (30 us rms jitter + 50 us steps): step jitter 47 -> 1.7 us rms at
    req_k 0.05. Default 0 keeps the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
2026-10-27 usb: bound the text wait by time, keep the watchdog fed
    cdc_tx_text spun up to 200000 times per write while the IN ring was
    full, without kicking the watchdog, and returned the short count, so
    newlib retried the rest with another full spin. A `show adc0` to a host
    that paused reading for 1.5 s reset the spindle drive (IWDG pin, bench
    27 Oct, reproduced).
    Now a write waits at most 20 ms (CDC_TEXT_WAIT_MS), kicking the
    watchdog meanwhile, then drops the rest and reports it written. After a
    timeout, text is dropped at once until the ring has room again.
    Claude-Session: https://claude.ai/code/session_012MzzmyYeJVci3x4L1Po9oG
2026-10-27 enc_fb: interpolated position relative to the index (iabs_pos)
    abs_pos is built from the bare counter. The sserial template sends
    idx_home0.pos_out, which switches from mot_fb to mot_abs_fb once the
    index is found, so a config using ipos lost the sin/cos interpolation
    from the first spindle index on (spindle, 512 counts/rev, 300 rpm:
    revs step sd 0.00047 before the index, 0.00106 after, on whole counts;
    Z buzzed in G33.1).
    New output iabs_pos = minus(ipos, offset). The Fanuc a2 spindle encoder
    configs and the sin/cos example in feedback.md link it to
    fb_switch0.mot_abs_pos. abs_pos is unchanged for plain encoders.
    Claude-Session: http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
2026-10-27 enc_fb: ipos from counter + sin/cos without the A/B pins, offset tracking
    The old merge corrected the count by the A/B pin levels read in the rt
    interrupt. The pins are raw, the counter sees them through its input
    filter, so a short spike or a pin read off the counter moved ipos a
    whole count for one sample: 0.8 % of samples at 300 rpm on the spindle
    (single ended magnetic sin/cos), 1 kHz step sd 0.11 count against
    0.012 for the angle alone.
    ipos now takes the line from the raw counter and the place in the line
    from sin/cos: the analog position (+ 4 n) closest to the counter. The
    counter phase kq is learned once from samples where the pins agree
    with the analog quadrant (64 in a row). Until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
2026-10-28 procedures: induction motor (ACIM) commissioning
    Plate values for id_acim, delta vs star, the rotating and pole pair
    tests, choosing vf / vf_enc / acim_foc / sl_acim, tr and temperature,
    thermostat contacts and sin/cos sensor inputs.
    Claude-Session: https://claude.ai/code/session_01HvkdgyH8n4bs17Re4hbC3P
2026-10-28 procedures: components, review checklist, sim scenarios; CI build with GCC 12.2
    components.md: where a component goes, pin and rt rules, defaults off,
    templates and rt_prio. review-checklist.md: what to check before a
    change is done. sim-scenarios.md: when and how to add a tests/sim
    scenario. .github/workflows/firmware.yml builds F4 and F3 in Debian
    bookworm (GCC 12.2, as upstream) and runs the host simulation on every
    push and pull request. Two more thin skills point at the new pages.
    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
2026-10-28 flashing: F4 bootloader first, as a hard step
    An app flashed through a bootloader older than f95f64fd can fail
    mid-erase in the ROM DFU and leave a board that hangs with nothing on
    USB until BOOT0 is held high at power-up (seen on 26 Oct). The version
    number does not tell, so check the bootloader's hash in about.
    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
2026-10-28 ramp: constant power limit on acc/dec (j, p_acc, p_dec)
    Above the speed where p / (j * |vel|) falls below max_acc the ramp follows
    what a power limited drive can deliver instead of running ahead with the
    speed loop saturated (spindle α2 at 600 rad/s^2: actual 515 at 4500 rpm,
    358 at 6000, 261 at 7500 with p_boost 1.68). p_dec caps the regenerated
    power when braking from high speed.
2026-10-28 conf: a2 spindle: shorter ramp comment (appendconf line limit)
2026-10-29 acim_foc: lower current limit near 0 Hz output (max_cur_0, f_lf)
    Near standstill the phase currents are almost DC, so one IGBT carries the
    peak all the time. The IM06B50GC1 on the spindle is rated IC 35 A per IGBT
    DC against IO 50 A. With max_cur_0 set, the limit is max_cur_0 at 0 Hz and
    rises linearly to max_cur at f_lf (default 2 Hz); d keeps priority, so only
    the torque is cut. The acim_foc template links acim_foc0.vel = angle0.vel;
    the spindle examples set max_cur_0 30. Off by default.
    Claude-Session: https://claude.ai/code/session_01TbaTrS6F86HBmJ3ii4CwUv
2026-10-29 acim_foc: flux cut (k_cut), the flux boost's downward twin
    While the flux is above the d command (going into field weakening), d is
    lowered by k_cut * (i_mr - d), at most to 0, so the rotor flux follows
    acim_fw in about tr / (1 + k_cut) instead of lagging the 1/speed target.
    Spindle sim, 300 <-> 838 rad/s at full power (p_boost 1.68, max_acc 500):
    duty above 0.95 for 320 ms before, never with k_boost 2 + k_cut 2; trim
    0.72..1.16 -> 0.92..1.06, peak current 21.4 -> 22.6 A, speed and ramp
    times unchanged. The spindle examples set k_boost 2, boost_max 0.3,
    k_cut 2. Off by default.
    Claude-Session: https://claude.ai/code/session_01TbaTrS6F8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
2026-10-29 io: track the current offsets while disabled; curpid: proportional voltage limit option
    io0 calibrated the current offsets once at boot, so shunt amplifier drift
    as the board warms stayed in them until reset. The offsets now follow the
    readings while the bridge is off: hv_en 0 and no short brake, after 20 ms
    off, and only while every phase reads under 1 A (a motor coasting above
    the link voltage drives diode current). First order low pass, io0.ofs_tau
    (default 2 s, 0 = boot only); the enable edge freezes them. A drift over
    io0.ofs_max (0.5 A) from the boot value raises HV_CURRENT_OFFSET_FAULT,
    sticky like the boot check. The tracking runs from flash.
    curpid gets vlim_mode: 0 keeps today's d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
2026-11-02 enc_fb: ipos from counter + sin/cos without the A/B pins, offset tracking, iabs_pos
    with the analog quadrant (64 in a r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
2026-11-02 ramp: constant power limit on acc/dec (j, p_acc, p_dec)
    The a2 spindle example keeps its ramp comment within the appendconf
    line limit.
    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
2026-11-02 acim_foc: lower current limit near 0 Hz (max_cur_0, f_lf) and flux cut (k_cut)
    - Near standstill the phase currents are almost DC, so one IGBT carries the
    - While the flux is above the d command (going into field weakening), d is
    acim_fw in about tr / (1 + k_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
2026-11-02 curpid: inductance floor 0.1 mH, delay predictor error correction; a2 spindle current feed forward on
    The 1 mH floor raised the a2 spindle's 0.747 mH to 1 mH: 34 % more
    proportional gain than cur_bw asks for, cross coupling feed forward 34 %
    high and a delay predictor that corrected only 75 % of the step. 0.1 mH
    still keeps an unset (0) inductance from zeroing the gain or blowing up
    the predictor's 1 / l.
    Voltage the motor model lacks (dead time, an r or psi error) shifted
    every prediction by about u * period / l, and the integrators then held
    the prediction, not the current, on the command: in the id_acim sim an
    8 A step settled at 7.30 A (7.05 A with the 0.1 mH floor). Each
    prediction is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
2026-11-02 sl_seq: own acceleration after the handover (acc_run)
    acc limited both the I/f start and vel_ref after the handover, so the
    spindle took 8.5 s to 8000 rpm at acc 100, and acc 500 made a fast I/f
    that stepped the current at the handover (31 A, fault 16 at fluxopt 0.6).
    acc_run (0 = acc) ramps vel_ref after the handover; sl_acim links it to
    conf0.max_acc so ramp0 sets the run-up. Sim, spindle max_acc 500: 830
    rad/s at 2.98 s (529 at 6 s before), peak 23.7 A.
    The sensorless a2 spindle config gets the power ramp (ramp0.j, p_acc,
    p_dec) as in the encoder variant, sl_seq0.acc 100 for the I/f start
    only, and the 2 Nov bench results in its header: 2.6 s to 830 rad/s
    with acc_run, peak 24.6 A, fluxo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
2026-11-02 Port to STMBL v4.0 with the IRAM256-2067A, drop v5
    The F3 image now targets the v4.0 power stage only:
    - HV_EN is FLT/EN: high runs the module (HV_EN_ON/OFF), and clock_init
    drives PA15 low before anything else (JTDI pull-up after reset).
    - hv_temp reads the IRAM's 47k B4050 NTC on its own Vth pin (10k pull-up)
    in any state; the HV_EN gate and the held/decaying value are gone.
    - ABS_MAX_CURRENT 30 A (module peak), ABS_MAX_TEMP 100 C (Fig. 9).
    - ipm defaults from the IRAM256-2067A datasheet, ocdac theory map
    (dac0 124, k 3.57, cur 28) until a board is measured with id_dac; the
    sim plant's comparator uses the same map.
    - Board configs and the wiki (supply, errors, tuning, introduction)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
2026-11-02 V4: fit the IPM model to the IRAM curves, retune the sim scenarios
    - ipm: v_tc, ei_tc and ed_tc fitted so the total loss matches the
    IRAM256-2067A loss curves at Tj 150 C (Fig. 6 and 7, within 4 %); the
    table values alone were 27 % (conduction) and 67 % (switching) low.
    - Spindle configs: the alpha 2 ones (19 A magnetizing at standstill, more
    than the IRAM carries) are replaced by conf/fanuc_a05_spindle_*.txt for
    the Fanuc alpha 0.5 (A06B-0866-B380): plate values from the nameplate
    and the Fanuc manuals, electrical values estimated and marked [est].
    - Spindle sim scenarios run the alpha 0.5 plant; idacim windows are set
    around its truth, sensorless reversal timing and two finding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
2026-11-02 V4 review fixes: sbrake fault pin, first hv_temp, sense cap note
    - io: while short braking, the fault pin counts from the third tick.
    PB7 reads the FLT/EN node that HV_EN drives, which was low until
    braking raised HV_EN, so with ignore_fault_pin 0 the first tick
    tripped HV_FAULT_ERROR at once.
    - io: hv_temp starts once rt has sampled the ADC, not from a 0 reading
    filtered up at 1 % per nrt pass.
    - hv0.dac: note the v4.0 board's 18 pF sense caps (switching ringing).
    - fanuc_a6-3000: the standstill hold exceeds the IRAM on v4.0.
    Claude-Session: https://claude.ai/code/session_01APi54132ePid1yhXM3NuJr
2026-11-02 V4: dead time 2.0 -> 1.19 us
    The IRAM256-2067A needs at least 1 us. DTG code 150 is 172 ticks at
    144 MHz, about 20 % above that. Less dead time means less distortion
    and a smaller dead time drop: drop_k = 1 is now 1.8 % of udc at 15 kHz.
    - idpmsm's HV_DEADTIME and the sim plant's default dt_eff follow the
    new value; the scenarios with an explicit dt_eff are scaled to it.
    - alpha 0.5 V/f configs: u_boost 18 -> 11 V. With the smaller drop 18 V
    over-fluxed the rotor at rest (i_mr 11 A) and V/f encoder braking
    hunted without settling; 11 V holds i_mr near id_n and stops cleanly.
    - id_acim r/tr and fo_trim k windows widened for the shifted readings
    (tr +4 % instead of -4 %), with the val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
2026-11-02 V4: alpha 0.5 estimates from the Fanuc 9D20 data, main's acim_foc keys
    - alpha 0.5 [est] values: tr 0.07 -> 0.04 s (Fanuc 4113 1000 vs the
    alpha 2's 450, scaled by our measured alpha 2), magnetizing 7 -> 5.1 A
    pk (4110 ratio), lmr 15.7 -> 21.6 mH at the same 0.11 Vs flux; V/f
    slip_n 6.6 -> 13 rad/s. Headers give the derivation.
    - FOC configs take main's acim_foc keys: max_cur_0 7.5 A (the IRAM's
    near DC limit, Fig. 5 at Tc 100 C), k_boost 2, boost_max 0.3, k_cut 2;
    encoder configs enc_fb0.off_k 0.0002.
    - acim_foc doc and template give the IRAM as the max_cur_0 example.
    - Spindle scenarios run the new plant; idacim windows reset to its truth.
    - tuning.md: alpha 0.5 magnetizing about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
2026-11-02 V4: alpha 0.5 configs take main's 2 Nov spindle keys
    - FOC configs: conf0.cur_ff 1 (as the alpha 2 bench run); cur_ind 1 on
    the encoder config, 0 on the sensorless one (in the sim 1 leaves the
    run up at 829 of 838 rad/s).
    - Encoder configs: enc_fb0 amplitude window at any speed, with the
    alpha 2 sensor's values marked [est].
    - drop_k stays the board estimate: the alpha 2's 0.98 is a v5 bridge fit.
    - id_acim_rot_tr: rot_tr_vel 600 -> 500. With main's curpid and id_acim
    template changes 600 reached the voltage limit at 566 rad/s and the
    check never finished.
    Claude-Session: https://claude.ai/code/session_01APi54132ePid1yhXM3NuJ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
